mxt-fr/BachelorProject/Robotic_arm/Circuit diagrams/tb6600_arduino_wiring.jpg

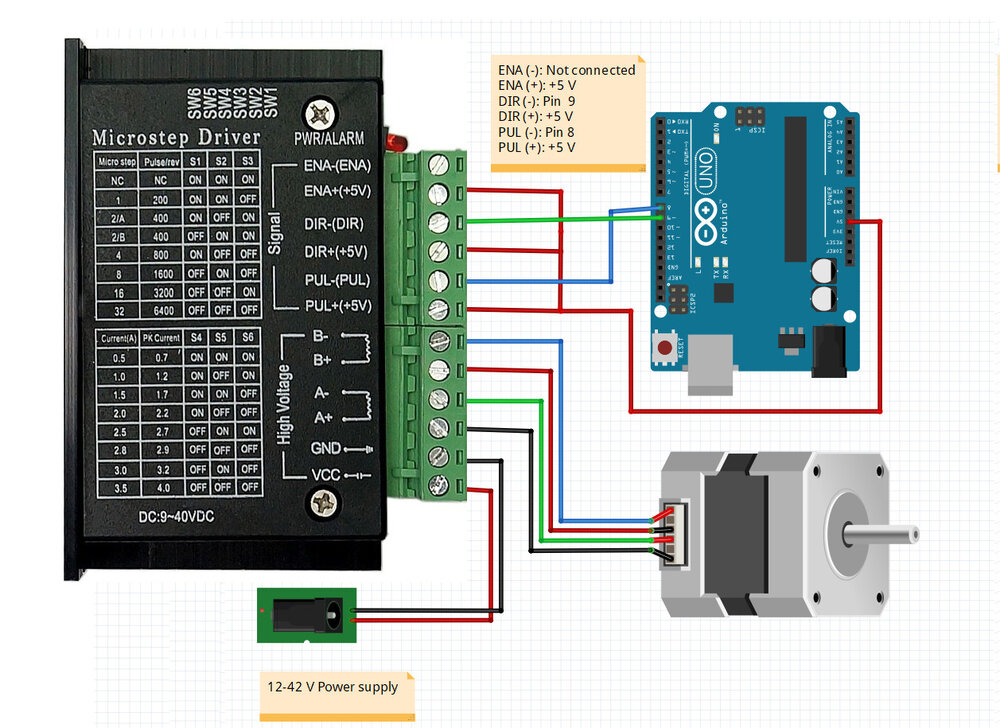
Robotic_arm/Circuit diagrams/tb6600_arduino_wiring.jpg
