mxt-fr/BachelorProject/Robotic_arm/Pictures/motor case.jpg

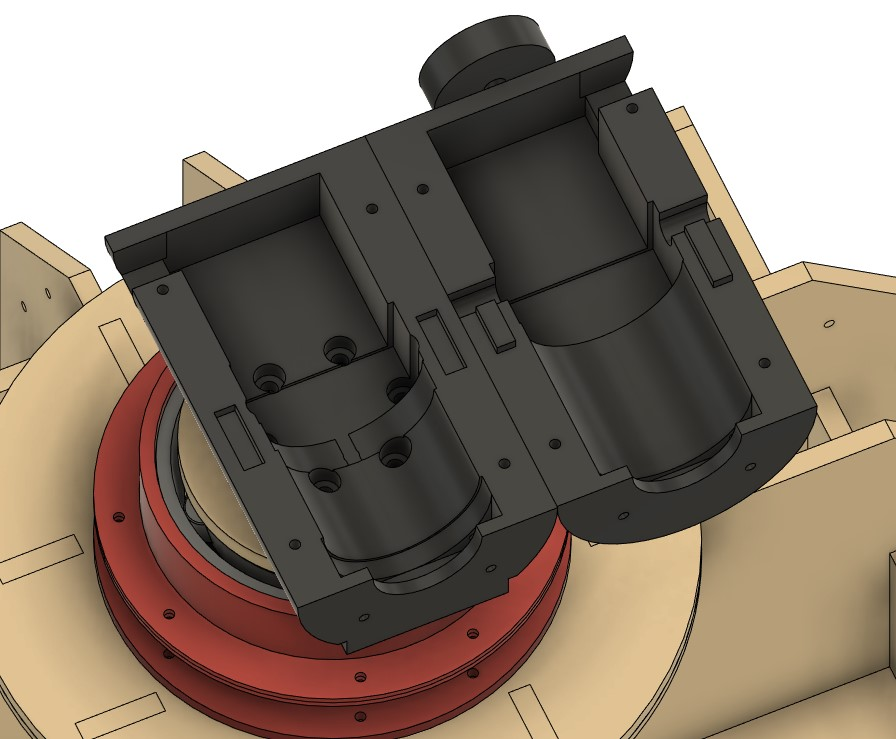
Robotic_arm/Pictures/motor case.jpg
