mxt-fr/BachelorProject/Robotic_arm/Pictures/Overview.png

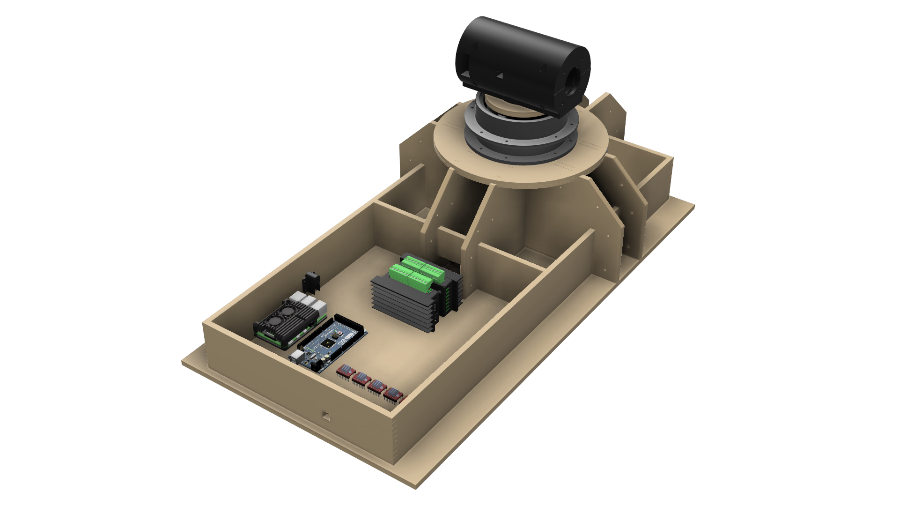
Robotic_arm/Pictures/Overview.png
