mxt-fr/BachelorProject/Robotic_arm/Pictures/Turntable.jpg

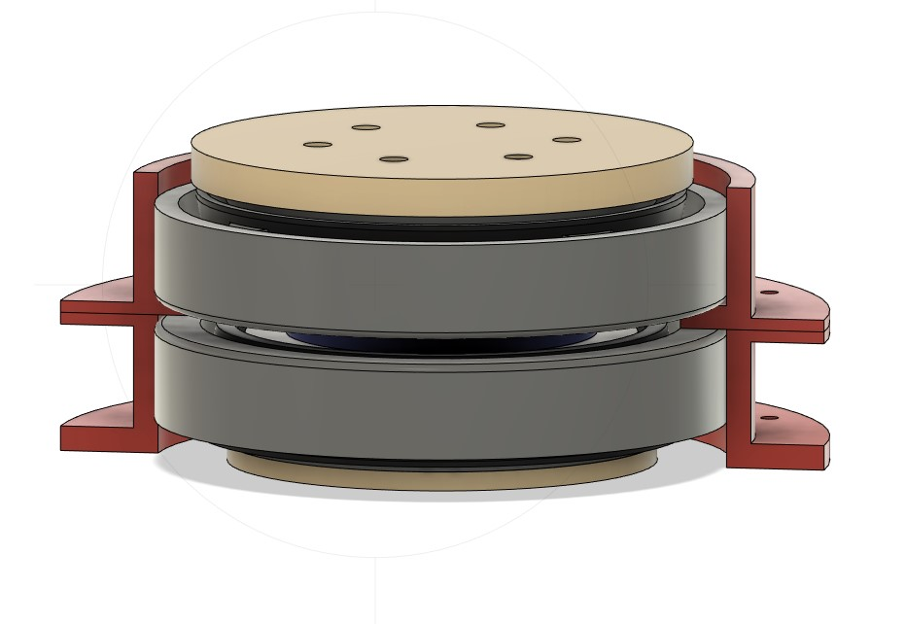
Robotic_arm/Pictures/Turntable.jpg
