mxt-fr/BachelorProject/Robotic_arm/3D models/Bachelor_Project.step

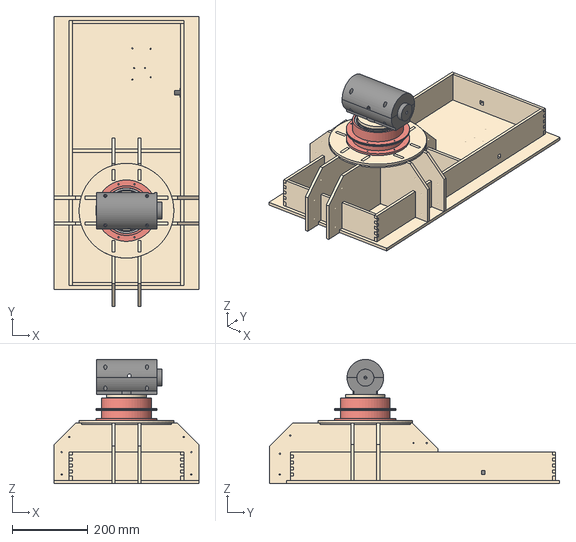
[picture p9: CAD file, 2023-06-09]
Robotic_arm/3D models/Bachelor_Project.step
382.0 x 764.8 x 327.6 mm
Robot arm base
30213-A x 2
