mxt-fr/BachelorProject/Robotic_arm/3D models/dxf files/Base/arm_short_1.dxf

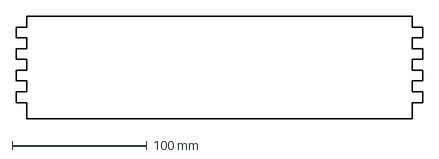
[picture p10: CAD file, 2023-06-09]
Robotic_arm/3D models/dxf files/Base/arm_short_1.dxf
302.0 x 76.0 mm
