mxt-fr/BachelorProject/Robotic_arm/3D models/dxf files/Circular plate/plate top.dxf

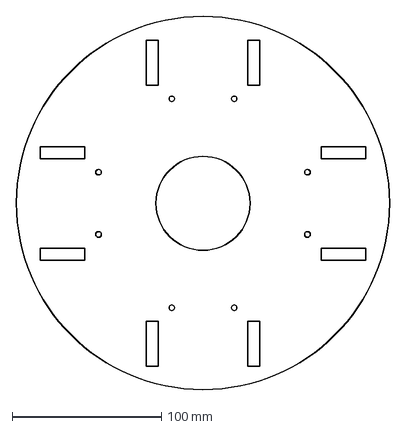
[picture p11: CAD file, 2023-06-09]
Robotic_arm/3D models/dxf files/Circular plate/plate top.dxf
250.0 x 250.0 mm
