mxt-fr/BachelorProject/Robotic_arm/3D models/dxf files/Turntable/top_slice.dxf

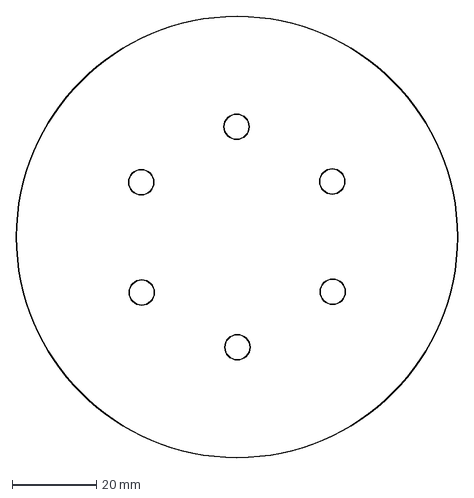
[picture p12: CAD file, 2023-06-09]
Robotic_arm/3D models/dxf files/Turntable/top_slice.dxf
105.0 x 105.0 mm
