mxt-fr/BachelorProject/Robotic_arm/3D models/Electronics/TB6600 stepper motor driver.STEP

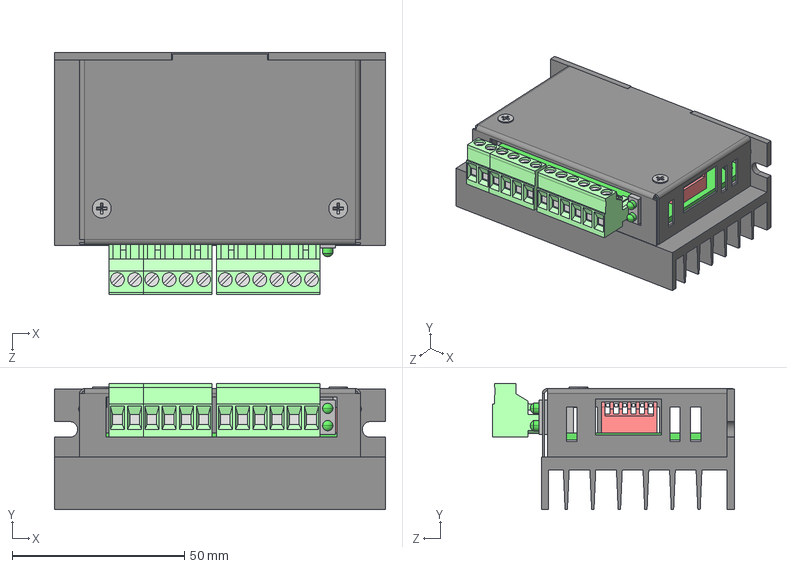
[picture p13: CAD file, 2023-06-09]
Robotic_arm/3D models/Electronics/TB6600 stepper motor driver.STEP
96.0 x 36.6 x 70.3 mm
