mxt-fr/BachelorProject/Robotic_arm/3D models/stl files/Base/driver breadboard holder 1.stl

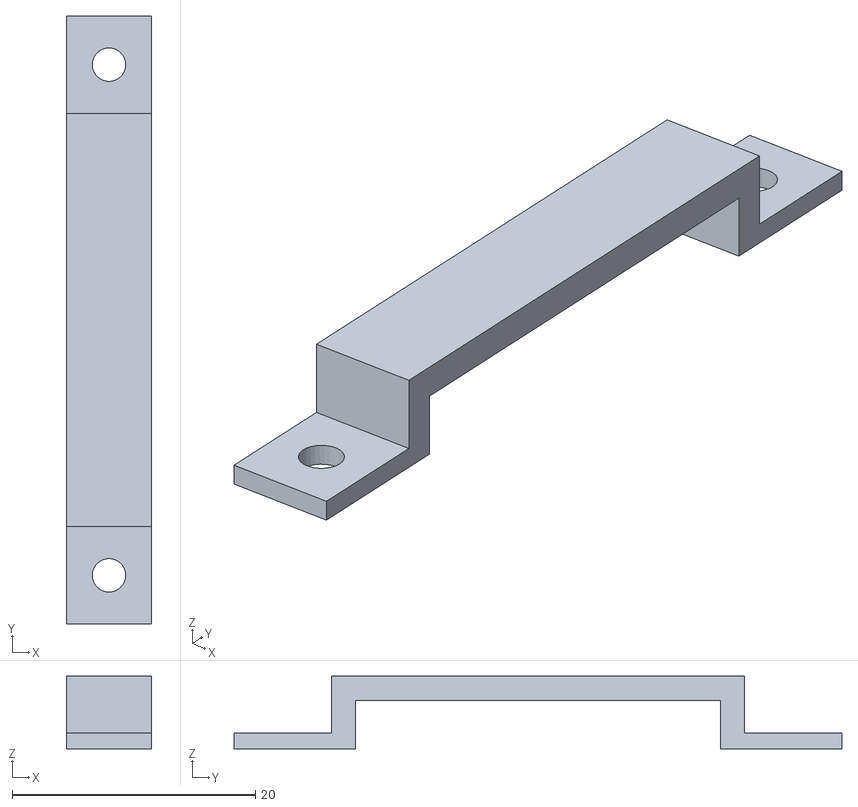
[picture p14: CAD file, 2023-06-09]
Robotic_arm/3D models/stl files/Base/driver breadboard holder 1.stl
7.00 x 50.0 x 6.00
