mxt-fr/BachelorProject/Robotic_arm/3D models/stl files/Motor case/Motor holder top.stl

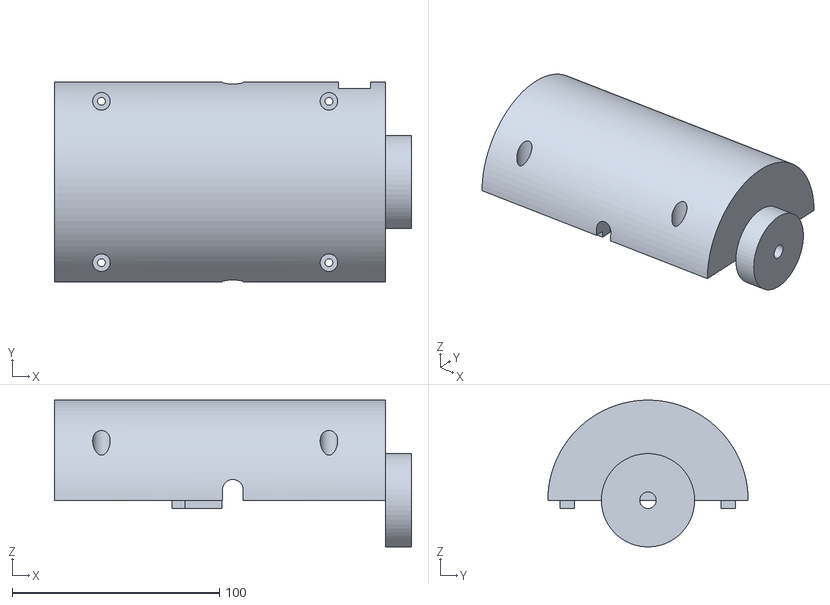
[picture p15: CAD file, 2023-06-09]
Robotic_arm/3D models/stl files/Motor case/Motor holder top.stl
172.2 x 96.6 x 70.7
