mxt-fr/BachelorProject/Robotic_arm/3D models/stl files/Turntable/bearing connector top.stl

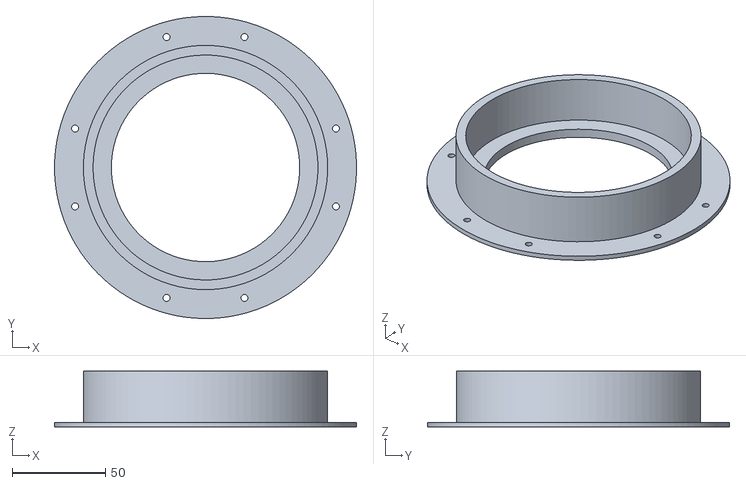
[picture p16: CAD file, 2023-06-09]
Robotic_arm/3D models/stl files/Turntable/bearing connector top.stl
162.0 x 162.0 x 30.0
