mxt-fr/BachelorProject/Robotic_arm/3D models/dxf files/Base/cross_1.dxf

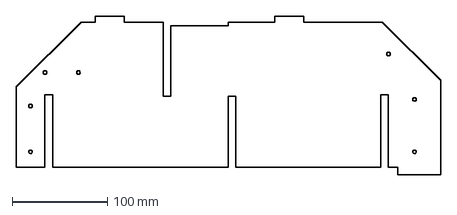
[picture p17: CAD file, 2023-06-09]
Robotic_arm/3D models/dxf files/Base/cross_1.dxf
444.8 x 166.0 mm
