mxt-fr/BachelorProject/Robotic_arm/3D models/dxf files/Circular plate/plate bottom side.dxf

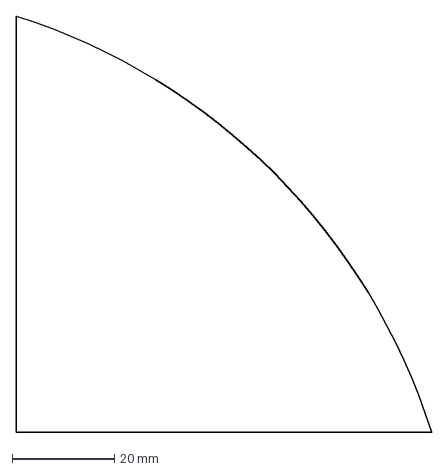
[picture p18: CAD file, 2023-06-09]
Robotic_arm/3D models/dxf files/Circular plate/plate bottom side.dxf
81.1 x 81.3 mm
