mxt-fr/BachelorProject/Robotic_arm/3D models/dxf files/Turntable/bottom_slice.dxf

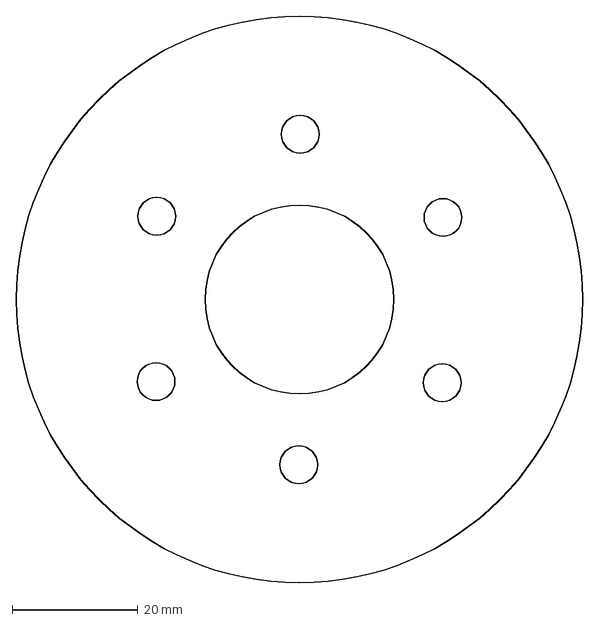
[picture p19: CAD file, 2023-06-09]
Robotic_arm/3D models/dxf files/Turntable/bottom_slice.dxf
90.0 x 90.0 mm
