mxt-fr/BachelorProject/Robotic_arm/3D models/Electronics/raspberry pi 4.step

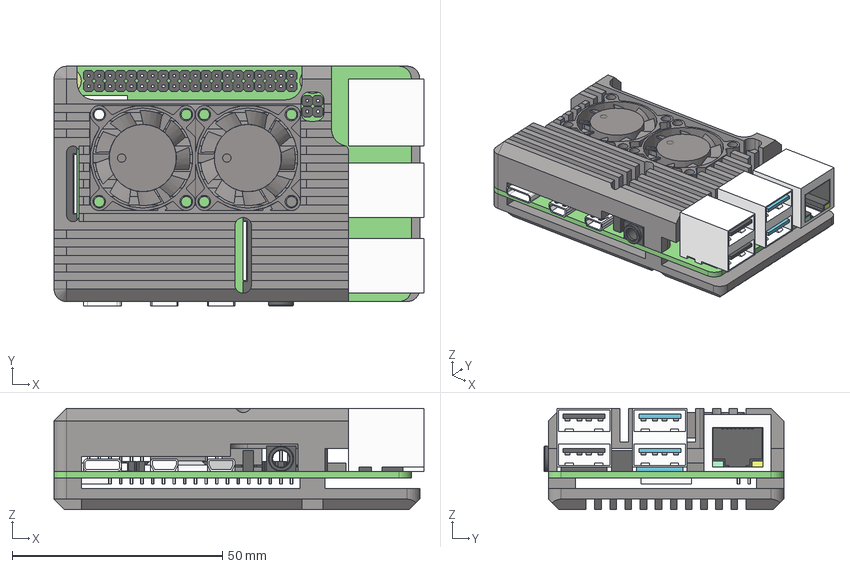
[picture p20: CAD file, 2023-06-09]
Robotic_arm/3D models/Electronics/raspberry pi 4.step
88.0 x 57.0 x 24.1 mm
радиатор верх
радиатор низ
вентилятор x 2
