mxt-fr/BachelorProject/Robotic_arm/3D models/stl files/Base/driver breadboard holder 2.stl

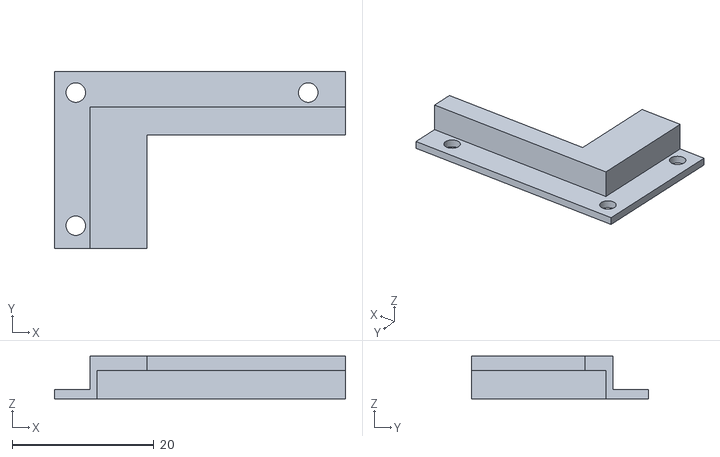
[picture p21: CAD file, 2023-06-09]
Robotic_arm/3D models/stl files/Base/driver breadboard holder 2.stl
41.0 x 25.0 x 6.00
