mxt-fr/BachelorProject/Robotic_arm/3D models/stl files/Motor case/Motor holder bottom.stl

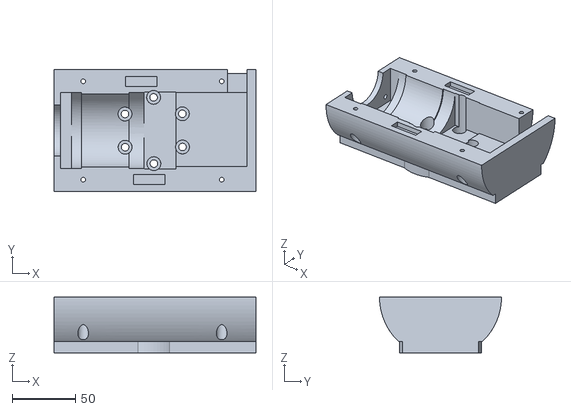
[picture p22: CAD file, 2023-06-09]
Robotic_arm/3D models/stl files/Motor case/Motor holder bottom.stl
160.0 x 96.6 x 44.0
