mxt-fr/BachelorProject/Robotic_arm/3D models/stl files/Turntable/Middle axle.stl

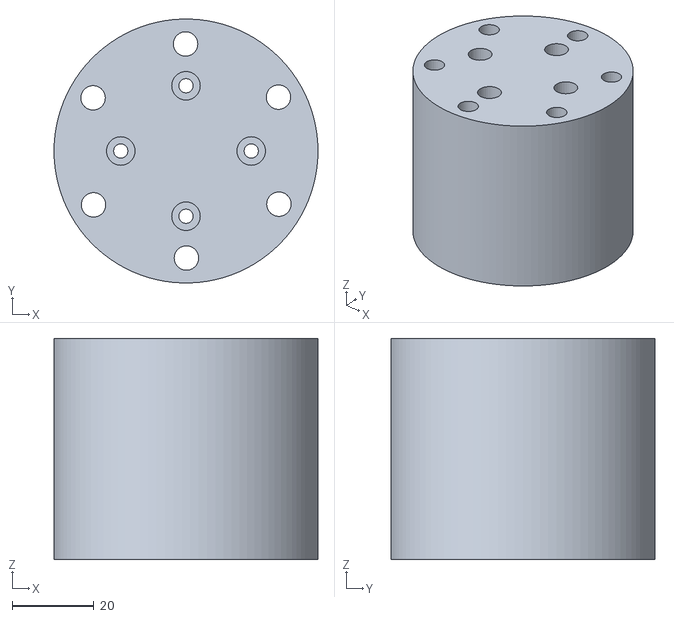
[picture p23: CAD file, 2023-06-09]
Robotic_arm/3D models/stl files/Turntable/Middle axle.stl
64.8 x 64.7 x 54.2
