mxt-fr/BachelorProject/Robotic_arm/3D models/dxf files/Base/Bottom plate.dxf

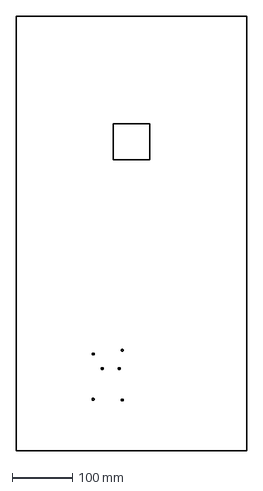
[picture p24: CAD file, 2023-06-09]
Robotic_arm/3D models/dxf files/Base/Bottom plate.dxf
382.0 x 720.0 mm
