mxt-fr/BachelorProject/Robotic_arm/3D models/dxf files/Circular plate/plate bottom middle.dxf

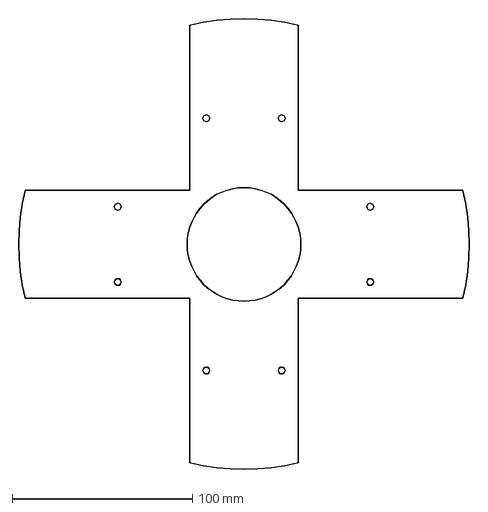
[picture p25: CAD file, 2023-06-09]
Robotic_arm/3D models/dxf files/Circular plate/plate bottom middle.dxf
252.5 x 252.4 mm
