mxt-fr/BachelorProject/Robotic_arm/3D models/Electronics/A4988 Step Driver.STEP

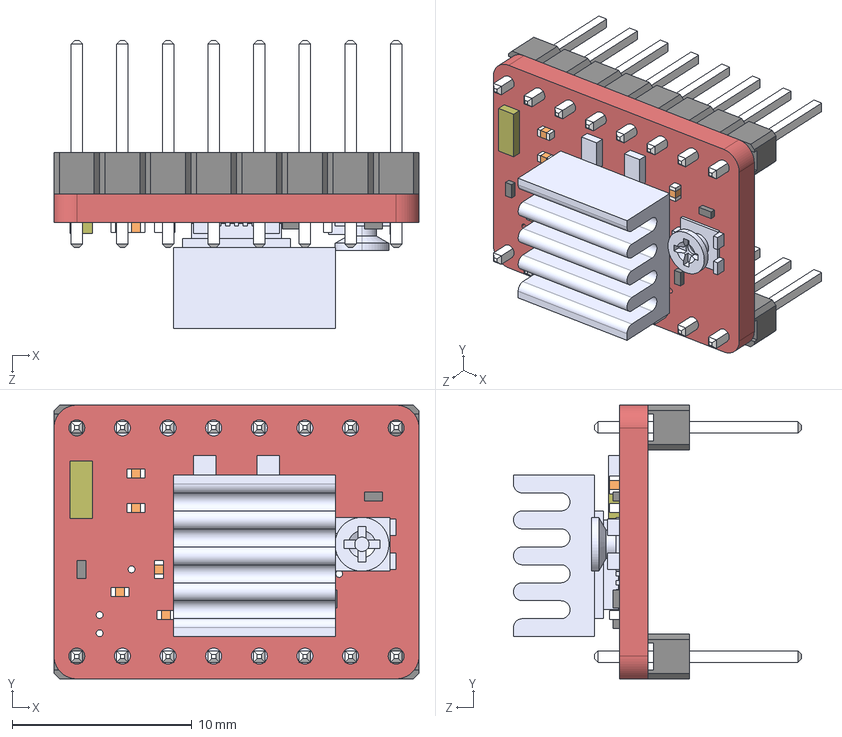
[picture p26: CAD file, 2023-06-09]
Robotic_arm/3D models/Electronics/A4988 Step Driver.STEP
20.3 x 15.2 x 16.0 mm
stepstick
0402CAP_CAP0402CAP x 6
1206_CAP1206
QFN28ET_A4983
0402RES_RESISTOR0402RES x 4
0805_RESISTOR x 2
TRIMPOT3MM_TRIMPOTSMD
Heatsink For A4988
Pin header pitch 2.54mm_08 contacts x 2
