mxt-fr/BachelorProject/Robotic_arm/3D models/stl files/Base/alimentation cable holder.stl

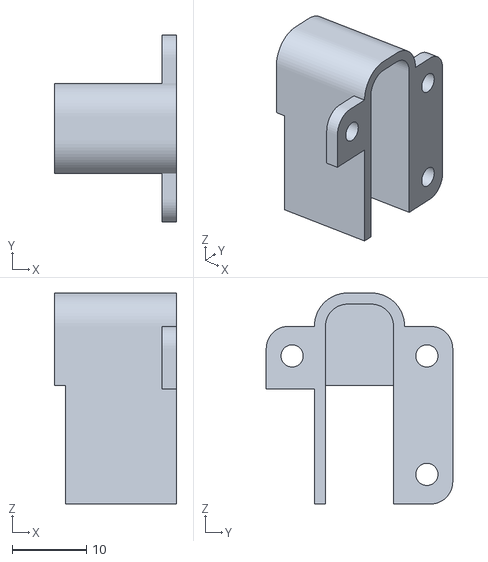
[picture p27: CAD file, 2023-06-09]
Robotic_arm/3D models/stl files/Base/alimentation cable holder.stl
16.5 x 25.2 x 28.5
