mxt-fr/BachelorProject/Robotic_arm/3D models/stl files/Turntable/bearing connector bottom.stl

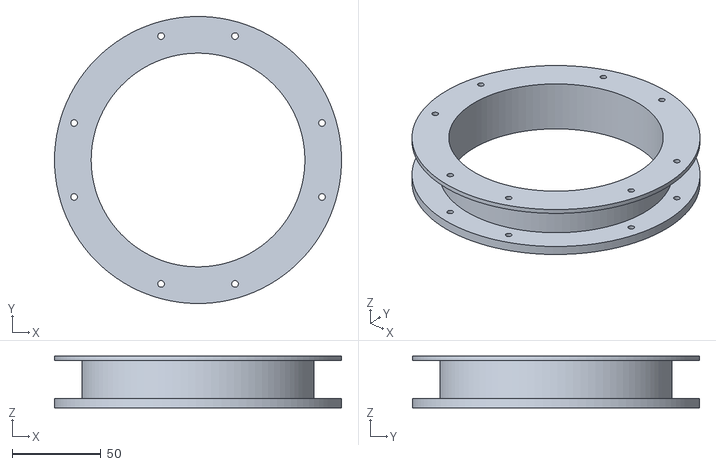
[picture p28: CAD file, 2023-06-09]
Robotic_arm/3D models/stl files/Turntable/bearing connector bottom.stl
162.0 x 162.0 x 29.2
