mxt-fr/BachelorProject/Robotic_arm/3D models/dxf files/Base/cross_4.dxf

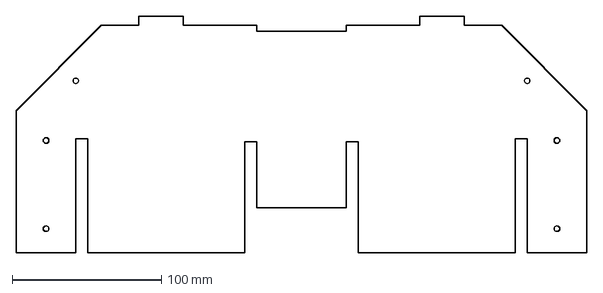
[picture p29: CAD file, 2023-06-09]
Robotic_arm/3D models/dxf files/Base/cross_4.dxf
382.0 x 158.0 mm
