mxt-fr/BachelorProject/Robotic_arm/3D models/dxf files/Base/arm_short_2.dxf

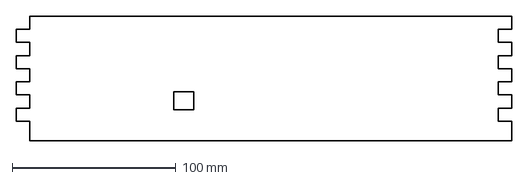
[picture p32: CAD file, 2023-06-09]
Robotic_arm/3D models/dxf files/Base/arm_short_2.dxf
302.0 x 76.0 mm
