mxt-fr/BachelorProject/Robotic_arm/3D models/dxf files/Base/cross_5.dxf

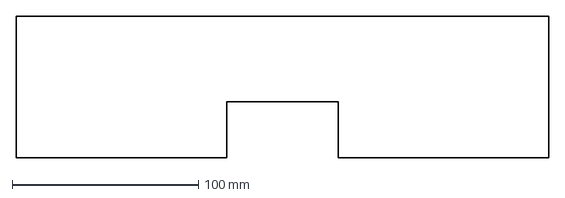
[picture p33: CAD file, 2023-06-09]
Robotic_arm/3D models/dxf files/Base/cross_5.dxf
286.0 x 76.0 mm
