mxt-fr/BachelorProject/Robotic_arm/3D models/dxf files/Base/Long_2.dxf

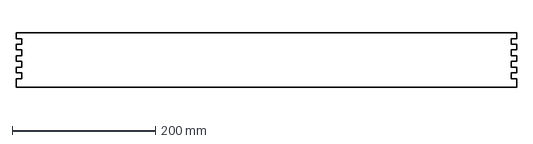
[picture p34: CAD file, 2023-06-09]
Robotic_arm/3D models/dxf files/Base/Long_2.dxf
700.0 x 76.0 mm
