mxt-fr/BachelorProject/Robotic_arm/Circuit diagrams/A4988 wiring.png

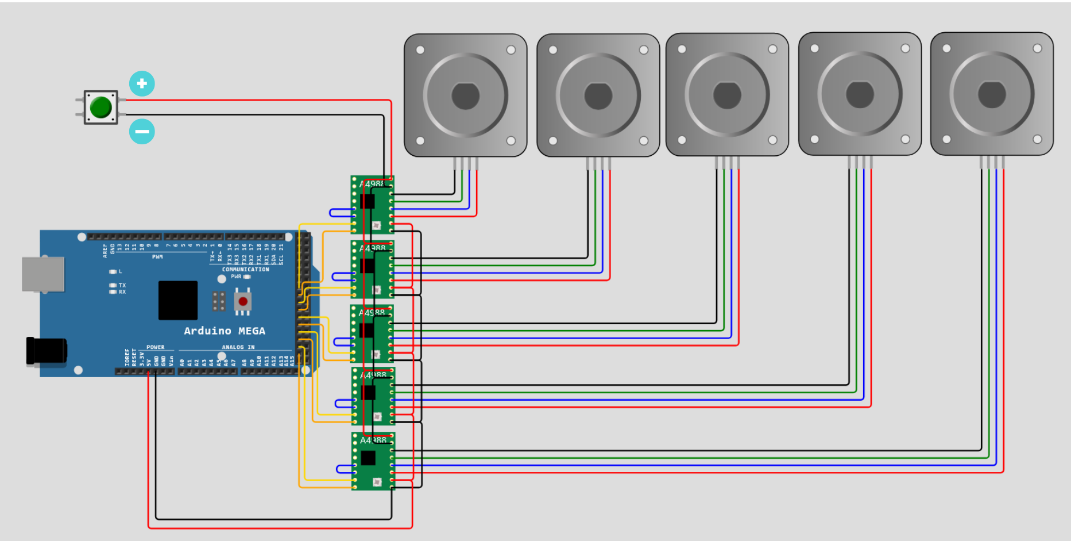
Robotic_arm/Circuit diagrams/A4988 wiring.png
