mxt-fr/BachelorProject/(commit log)

2023-06-09 Uploading all files
    [A4988 Step Driver.STEP, Bottom plate.dxf, Long_1.dxf, Long_2.dxf, Middle axle.stl, Motor holder bottom.stl, Motor holder top.stl, TB6600 stepper motor driver.STEP]
2023-06-09 added step file for whole 3D model
    [Bachelor_Project.step]
